asadbahauddin/solar-water-heater-pid-esp32/SCH_Agung_2026-09-14.pdf

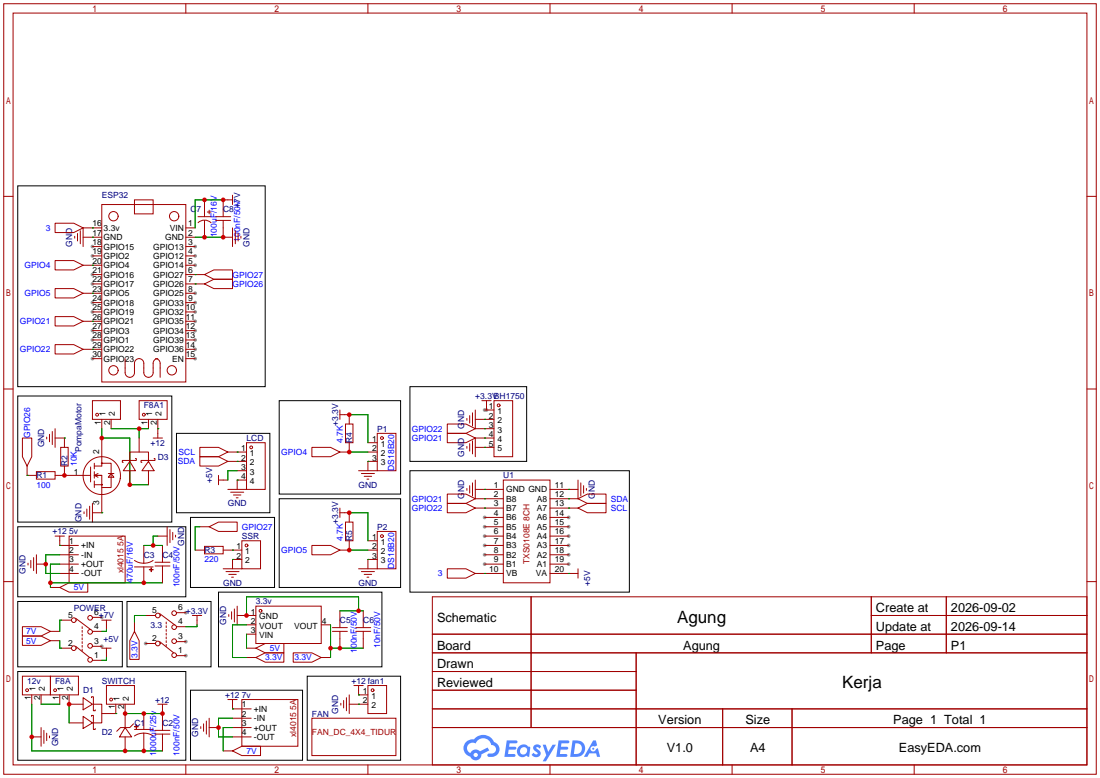
[picture p1: page 1]

Schematic | Agung | Create at | 2026-09-02

Board | Agung | Page | P1
Drawn | | Kerja
Reviewed

Version | Size | Page 1 Total 1
V1.0 | A4 | EasyEDA.com
