asadbahauddin/solar-water-heater-pid-esp32/PCB_Agung_2026-09-15.pdf

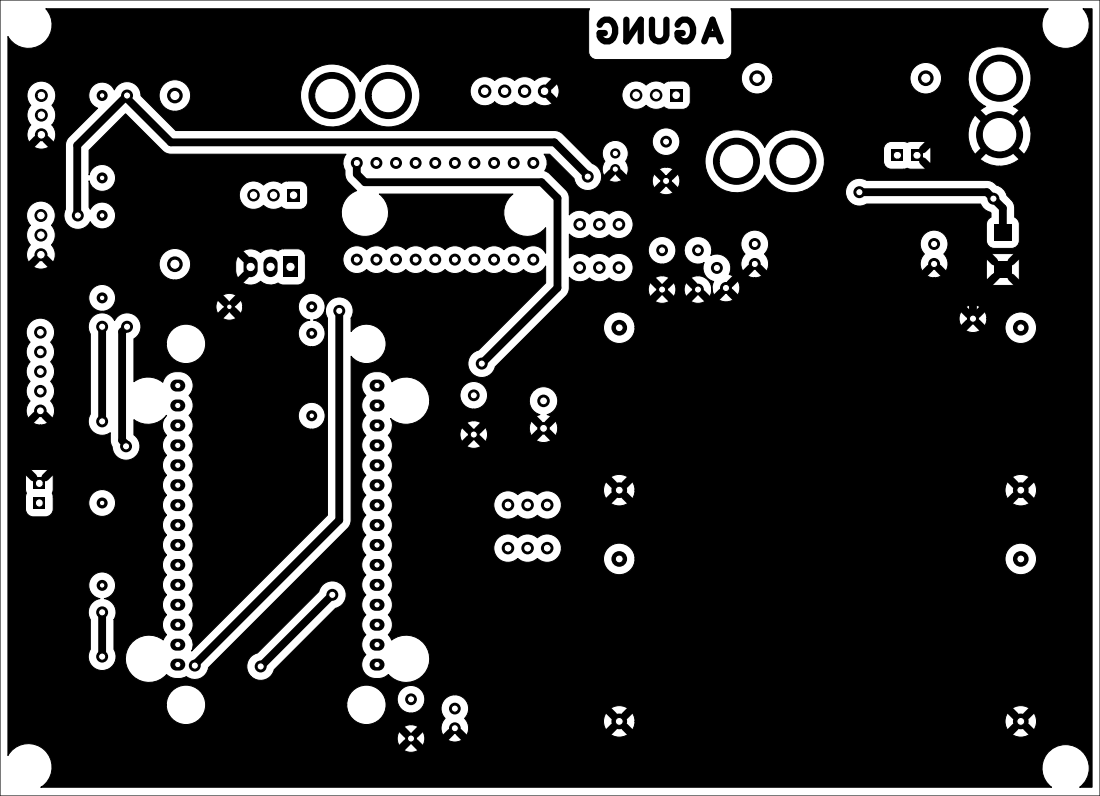
[picture p2: page 1]

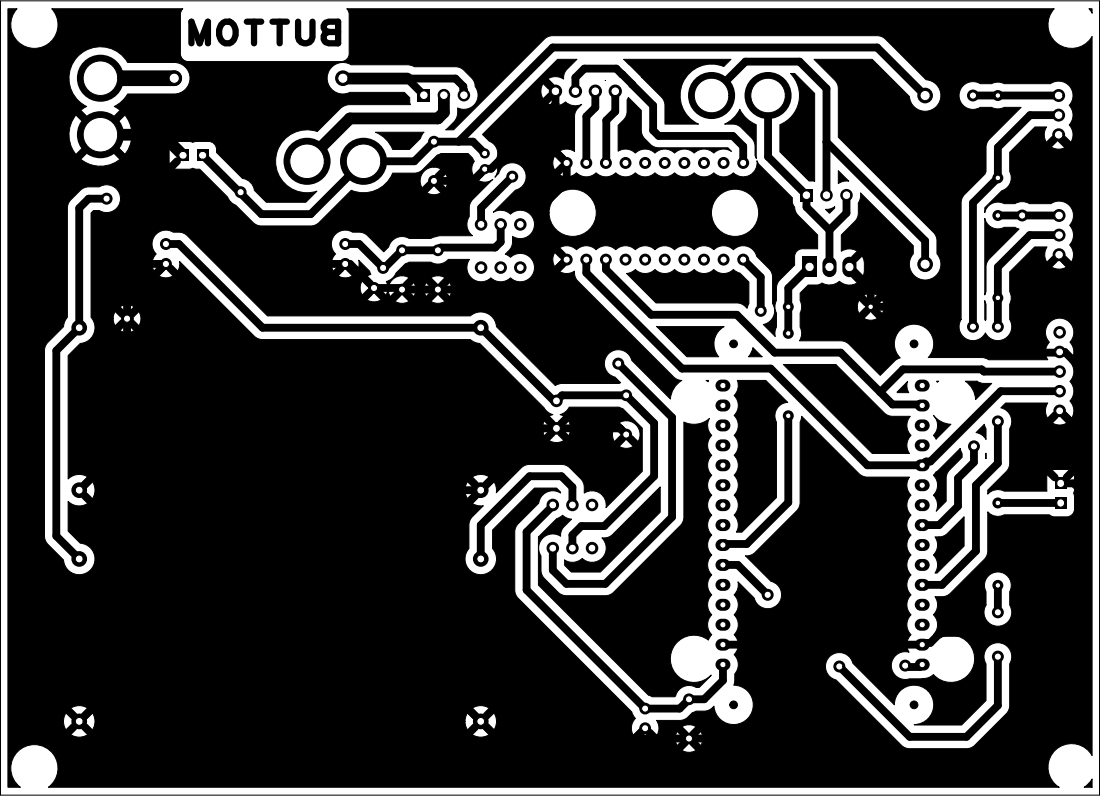
[picture p3: page 2]
