asadbahauddin/solar-water-heater-pid-esp32/(commit log)

2026-10-28 Initial commit: firmware ESP32 SWH PID, data logger, hardware design, dokumentasi
    [swh_log_20261011_220645.csv]
2026-10-28 Firmware v4: PID siang di pompa (sistem looping), histeresis lux, fix sensor -127
    - PID siang mengatur kecepatan pompa (PWM 20 kHz) dengan gerbang dT
    kolektor-tangki; PID malam tetap di heater, gain terpisah
    - Ambang siang/malam dua nilai (histeresis), bisa diubah dari dashboard
    - DS18B20 -127 dikonversi ke NAN; heater & pompa mati bila sensor tangki error
    - Safety cutoff mematikan pompa juga
    - Logger & grafik merekam pumpDuty dan parameter baru
    [Esp_agung.ino]
